JesseOceanMusic/Climate_Control/memes/01.jpg

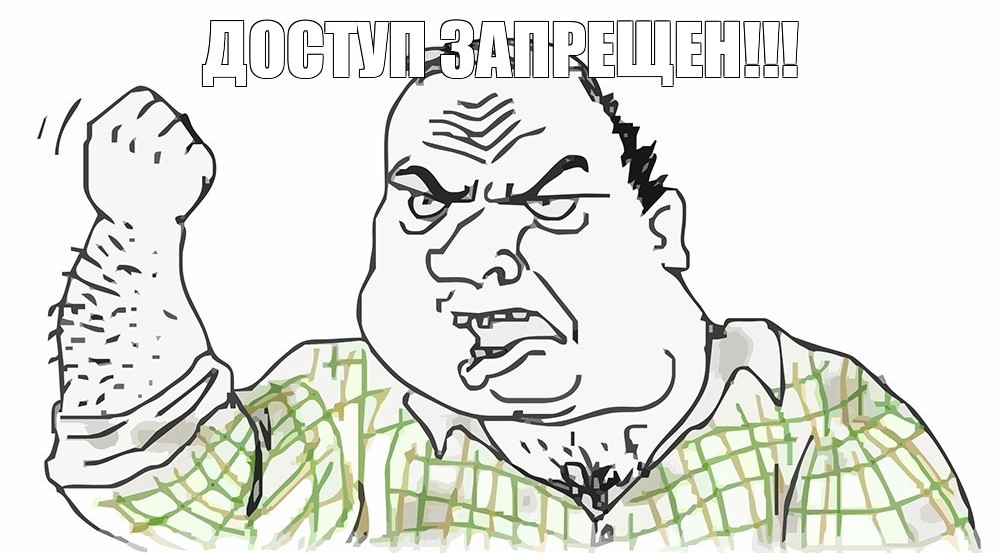
memes/01.jpg
