JesseOceanMusic/Climate_Control/memes/02.jpg

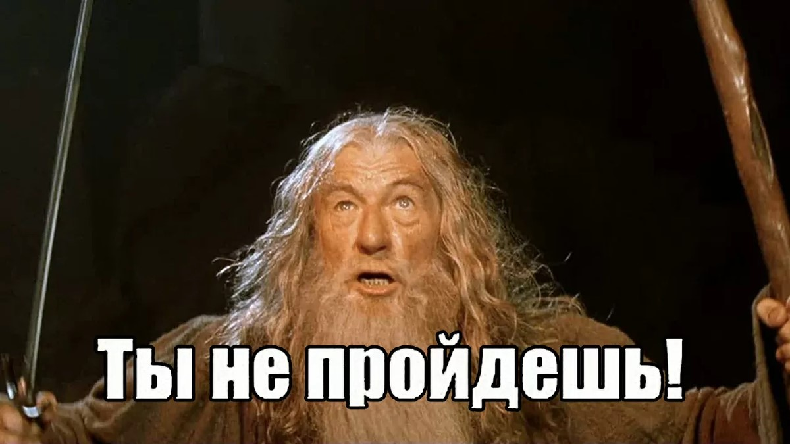
memes/02.jpg
