JesseOceanMusic/Climate_Control/memes/03.jpg

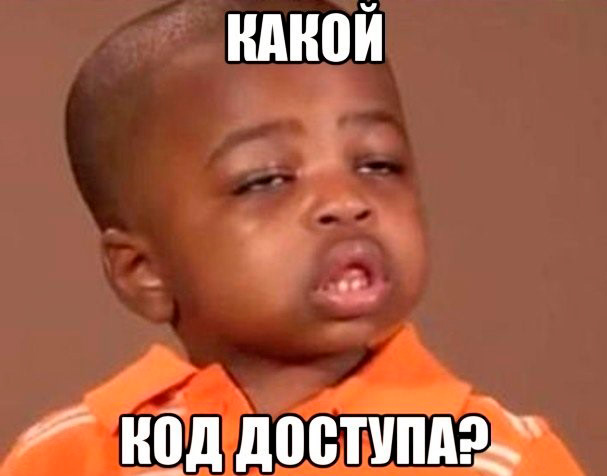
memes/03.jpg
