JesseOceanMusic/Climate_Control/memes/04.jpg

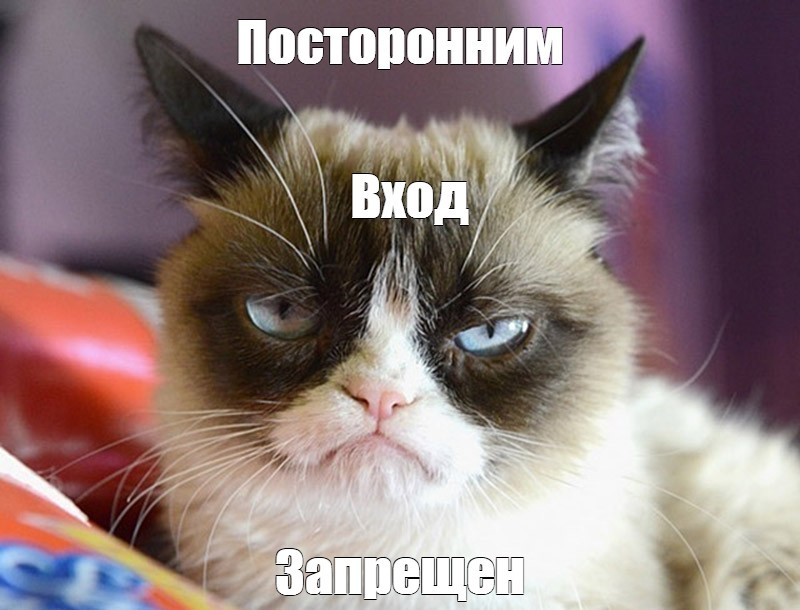
memes/04.jpg
