JesseOceanMusic/Climate_Control/memes/05.jpg

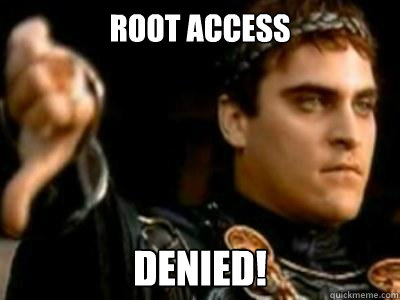
memes/05.jpg
