JesseOceanMusic/Climate_Control/memes/06.jpg

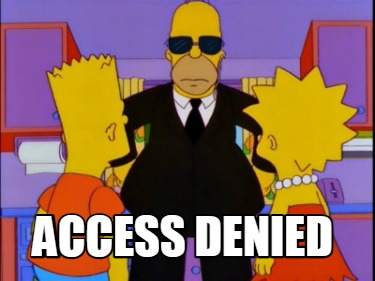
memes/06.jpg
