JesseOceanMusic/Climate_Control/memes/07.jpg

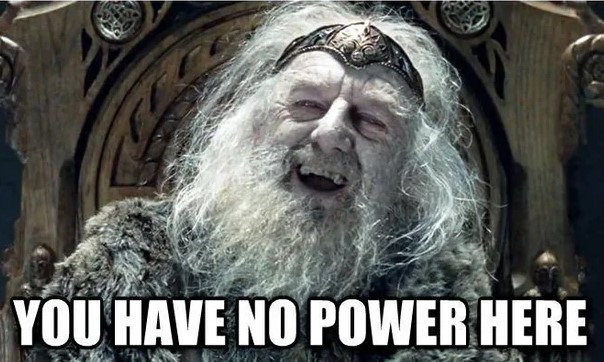
memes/07.jpg
