JesseOceanMusic/Climate_Control/memes/08.jpg

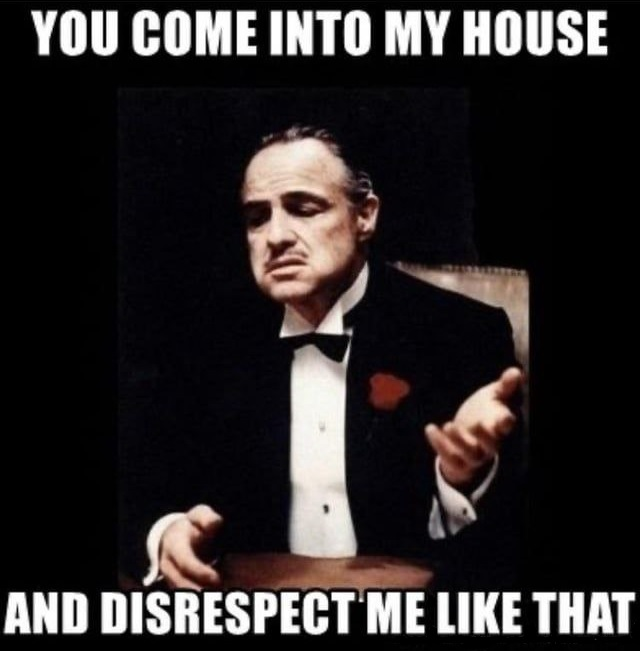
memes/08.jpg
