JesseOceanMusic/Climate_Control/memes/09.jpg

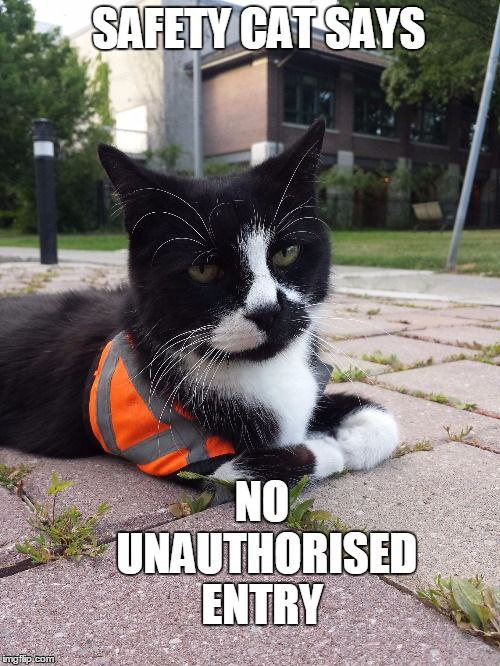
memes/09.jpg
