JesseOceanMusic/Climate_Control/(threads)

Thread 1 (2024-11-02):

Добавить класс для таймеров.

JesseOceanMusic, 2024-11-02:
```
class class_timer_ms()
{
   public:
   class_timer_ms(unsigned int duration)
   {
      _duration = duration;
   }

   bool is_ready()
   {
      if(millis() - _now > _duration)
      {
          _now = millis();
          return true;
      }

      else
      {
         return false;
      }

      private:
      unsigned long _now;
      unsigned int _duration;
   }
}
```

JesseOceanMusic, 2024-11-03:
Попробовал. Плохая мысль... Таймеры везде работают по разным принципам, какие-то находятся внутри классов итд итп...

Closed 2024-11-03.

Thread 5 (2024-11-02):

Chat - время лупа max ~1800ms.

JesseOceanMusic, 2024-11-02:
Разобраться, из чего складывается такая дикая задержка.

JesseOceanMusic, 2024-11-03:
Максимальная длина лупа теперь 500ms, когда отправляется сообщение в телеграм.
Дальше в оптимизации скорости нет смысла.

Closed 2024-11-03.

Thread 22 (2024-11-07):

Куда-то делись 5кб heap... Пока подозрение только на таймер отправки файла.

JesseOceanMusic, 2024-11-07:

JesseOceanMusic, 2024-11-08:
Да, судя по всему где-то ошибка во время отправки файла

JesseOceanMusic, 2024-11-08:
А может и не ошибка, просто в этот момент первый раз инициализируется второй бот

Попробовать добавить тик второго бота или это просто нормальное место для него

Closed 2024-11-09.

Thread 23 (2024-11-10):

Поменять сообщение на

JesseOceanMusic, 2024-11-10:
Выбран режим вентиляции: Рекуператор.

*В режиме Рекуператор стоит увеличивать количество приточного воздуха, чтобы было положительное давление в квартире и пыль/запахи не затягивало из щелей в стенах.
Скорость выставлять так, чтобы КПД рекуперации не вытяжку было на 10-20% больше, чем на приток.

Closed 2024-11-10.
